sparkfun/Lumenati_3x3/README.md

SparkFun Lumenati 3x3
========================================

SparkFun Lumenati 3x3

[*SparkFun Lumenati 3x3 (COM-14360)*](https://www.sparkfun.com/products/14360)

Designed to give your projects an edge in their lighting capacity, the SparkFun Lumenati 3x3 is a small, rectangular board equipped with nine APA102C LEDs arranged in a 3x3 array. The 3x3 board can be daisy-chained with other Lumenati boards, allowing for multiple design options and formations. 

Repository Contents
-------------------

* **/Hardware** - KiCad design files.
* **/Production** - Production panel files.

Documentation
--------------
* **[Example Code](https://github.com/sparkfun/SparkFun_Lumenati_Code)** - Python and Arduino example code for the Lumenati boards.
* **[FastLED Arduino Library](https://github.com/FastLED/FastLED)** - FastLED Arduino library when using the Lumenati with an Arduino.
* **[Hookup Guide](https://learn.sparkfun.com/tutorials/lumenati-hookup-guide)** - Basic hookup guide for the SparkFun Lumenati boards.

License Information
-------------------

This product is _**open source**_! 

Please review the LICENSE.md file for license information. 

If you have any questions or concerns on licensing, please contact techsupport@sparkfun.com.

Distributed as-is; no warranty is given.

- Your friends at SparkFun.

_<COLLABORATION CREDIT>_
