sparkfun/Lumenati_3x3/(commit log)

2017-06-08 First commit.
    [HiBeam_3x3.kicad_pcb, HiBeam_3x3.sch]
2017-06-09 Fixed silk.
    [HiBeam_3x3.kicad_pcb, HiBeam_3x3.sch]
2017-06-13 Moved the connectors to be more centered.
    [HiBeam_3x3.kicad_pcb, HiBeam_3x3.sch]
2017-07-05 Silk fixes.
    [HiBeam_3x3.kicad_pcb]
2017-08-14 Changed silk and file names to Lumenati
    [Lumenati_3x3.kicad_pcb, Lumenati_3x3.sch]
2017-10-23 Removing KiCad output files, updating .gitignore.
