sparkfun/Lumenati_3x3/(notices)

Notices in the files:
Hardware/Lumenati_3x3.kicad_pcb:
https://creativecommons.org/licenses/by-sa/4.0/w
